Confucij/Gravicapa/README.md

Gravicapa
=========
Универсальное устройства для слежения за аудиториями, сбора различной информации, её обработки и отображения.
