Confucij/Gravicapa/datasheet/lqfp64_pins.png

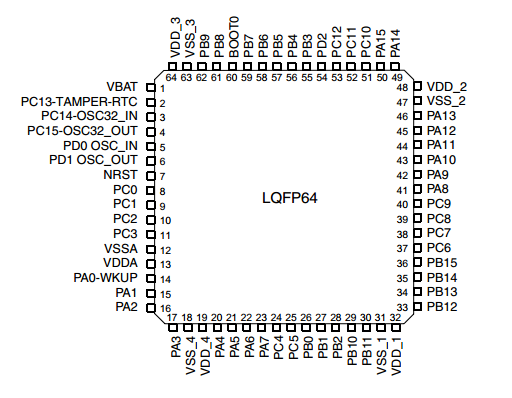
datasheet/lqfp64_pins.png
