Confucij/Gravicapa/documentation/Business Workflows.png

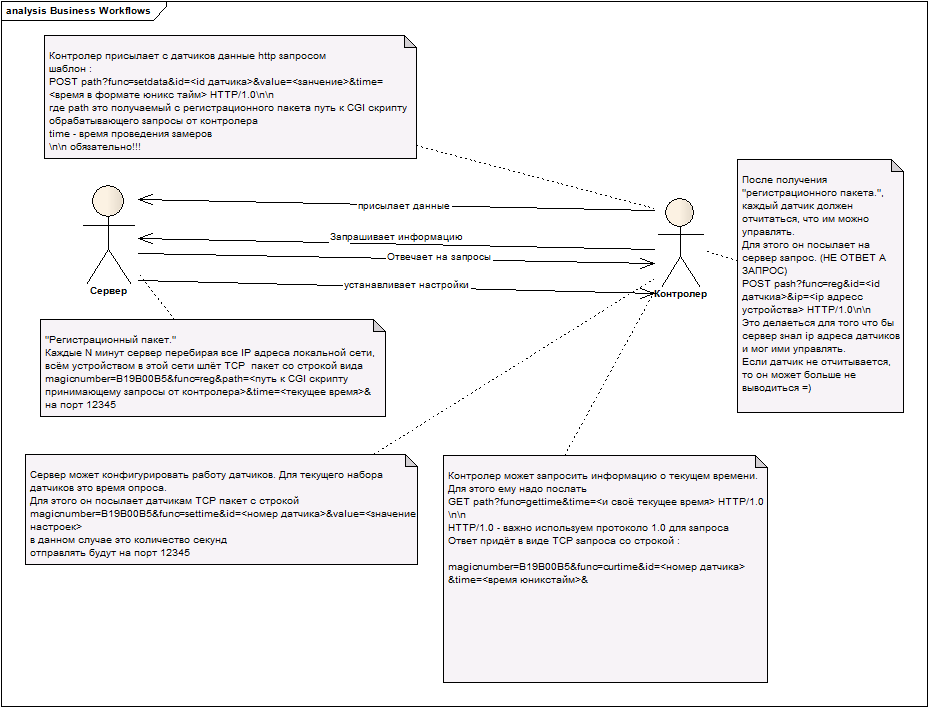
documentation/Business Workflows.png
