Confucij/Gravicapa/Component_select.md

Необходимое оборудывание
========================
    1. Связь с сервером.
        Ethernet.
             +простой контроллер( например);
             +наличие готового стека(uIP)
             +удобный интерфейс
             -необходимость наличия проводов с подключением к сети
            а)enc28j60
                Простая микросхема контроллер ethernet. 
                +Наличие готового кода.
                +Простота подключения
                -отсутствие TCP/IP стека
                -приличное количество багов
            б)W5100
                +аппаратная реализация протоколов TCP,  UDR  ICMR  IPv4 ARR  IGMR РРРоЕ, Ethernet;
                +встроенный 10BaseT/100BaseTX преобразователь физического уровня Ethernet;
                +автоматическое      определение режимов работы полный дуплекс, полудуплекс, 10 или 100 Мбит/с;
                +три способа подключения к микроконтроллеру. Direct, Indirect, SPI;
                +поддержка ADSL соединений по протоколу РРРоЕ;
                +возможность  работы   одновременно с четырьмя соединениями, каждое из которых настраивается для работы в режиме клиента или сервера;
                +16 Кбайт внутренней памяти, отведенной под буферы приема и передачи. 
                -Высше цена.
            в)W7200
                STM32F103CB+W5200                
                Максимальная частота работы 72 МГц (1,25 DMIPS/МГц).
                Область памяти данных (RAM) 20 Кб.
                Flash-память программ 128 Кб.
                7 таймеров:
                три 16-битных таймера и один вход для квадратурного кодера;
                два сторожевых таймера;
                24-битный вычитающий счётчик.
                Полнодуплексный UART.
                Блок аппаратного вычисления кода CRC.
                Внешние интерфейсы: GPIO, SPI, USART, I2C, CAN и USB.
                Режимы пониженного потребления энергии.
                Все возможности W5100 интегрированны внутрь
                +Повышение надежности за счет уменьшения числа компонентов
                +Отсутствие необходимости в еще одном контроллере для управления
                -Невозможность заменить процессор на плате на другой(Возможности заменить слабый STM на пожирнее и наоборот пропадает)
    2. Датчики
        а)Температура
            DS18B20
                +однопроводной цифровой интерфейс
                +возможность держать множество датчиков(не только температурных) на одной шине
        б)Потребляемая мощность
            ADE7753(ADE77**)
                Ошибка измерения активной составляющей мощности в диапазоне изменения тока 1000:1 менее 0.1 %
                Измерение активной, реактивной и допустимой мощности и СКЗ напряжения и тока
                Высокочастотный импульсный выход
                Измерение напряжения SAG, детектирование пересечения нуля, периода и пиковых значений напряжения и тока
                Режим накопления только положительной мощности
                Интерфейс с трансформаторными и дифференцирующими токовыми датчиками
                Встроенный температурный датчик и 2.4 В ИОН
                Низкое потребление: 25 мВт
            CS5460A
               Energy data linearity: ±0.1% of reading over 1000:1 dynamic range
               On-chip functions: energy, I * V, IRMS and VRMS, energy-to-pulse conversion
               Smart "Auto-Boot" mode from serial EEPROM
               AC or DC system calibration
               Mechanical counter/stepper motor driver
               Meets accuracy spec for IEC, ANSI, JIS
               Power consumption <12 mW
               On-chip 2.5 V reference (25 ppm/°C typ.)
               Interface optimized for shunt sensor
               Phase compensation
               Ground-referenced signals with single supply
               Simple 3-wire digital serial interface
               Watchdog timer
               Power-supply monitor
               Power supply configurations
                   VA+ = 5 V; VA- = 0 V; VD+ = 3 V to 5 V
                   VA+ = 2.5 V; VA- = -2.5 V; VD+ = 3 V
               Package: 24-pin SSOP; lead-free assembly
            MCP3905 
                +низкая цена
                +более доступна
                -не понятно как забрать показания
                -она вообще для этого нужна?
                The MCP3905 is an energy measurement IC supporting the IEC 62053 international
                energy metering specification. The output of the device includes a frequency 
                proportional to the average active (real) power at the inputs as well as a higher
                frequency output proportional to the instantaneous power for meter calibration. 
            STPM01
                труъ
               
        в)Освещения
            MAX44000
                Микросхема состоящая из датчика освещения и двух инфракрасных датчиков. Имеет встроенный драйвер для инфракрасного светодиода.
                Может быть использованна в качестве датчика присутствия. Интерфейс связи - I2C. 
            Фототранзистор/фотодиод
                Простой и дешевый способ реализации датчика освещения. Возможность определения только(?) наличия/отсутствия света. Необходимо подключать к АЦП.
        г)Открытие дверей/окон
            Геркон и постоянный магнит
    3. Карта памяти
        SD карта для ведения логов в отсутствии связи с сервером. Объем - от 1Гб.
    4. Видео/фотокамера
        Видеокамера позволяет вести наблюдение за помещением и передавать полученное изображение на сервер. В качестве камеры возможно использовать камеру от мобильного телефона
        или веб-камеру. 
        +Киллерфича.
        -Необходимы контроллеры с хорошей вычислительной мощностью
        -В случае с камерами от телефонов затруднено серийное производство
    5. Контроллер
        а)AVR
            +Простые в освоении и написании кода
            +Простые в распайке корпуса            
            -Малая тактовая частота(если необходим модуль с камерой частоты не хватит)
            -Сложно изменить применымый процессор - заменить менее производительный на более производительный так как зачастую нету полной совместимости выводов между корпусами
            -Производительные чипы с большими объемами памяти весьма дорогие.
        б)cortex-M3 от NXP
            +32х разрядное ARM ядро 
            +Высокие тактовые частоты
            +Большие объемы Flash и RAM
            -От линейки к линейке сильно меняется перевирия и распиновка чипов
            -Программировать сложнее чем AVR
        в)cortex-m3 от ST
            +32х разрядное ARM ядро 
            +Высокие тактовые частоты
            +Большие объемы Flash и RAM
            +Распиновка и внутренне устройство(адреса и названия регистров и т.п.) для различных по производительности контроллеров одинаковая, что позволяет, в зависимости от необходимой
            комплектации применять более или менее производительные чипы не внося изменений в программный код и конструкцию платы.
    6. Резервное питание, например http://forum.cxem.net/uploads/monthly_03_2011/post-55524-0-84197800-1300698730_thumb.jpg

Компоненты на главной плате
===========================
* Стабилизатор питания NCP1529
* Разъем Ethernet HR911105A
* Разъем microSD карты
* Ethernet контроллер enc28j60
* Посадочная площадка LQFP 64 под контроллер stm32(STM32F100RB для начала)
* Разъем батарейки cr2025(или другой плоской)
* Разъемы(штырьки) свободных i/o портов
* Разъемы(штырьки) шин i2C, 1-wire
* Температурный датчик
* Разъем питания
