Confucij/Gravicapa/scheme_and_board/component_order.ods

Название | Корпус | Цена | К-ство, шт | Ссылка | Комментарии | Сумма | Реально нужно, шт
kosmodrom.com.ua
STM32F100RBT6B | LQFP64 | 23.50 грн | 1 | http://www.kosmodrom.com.ua/el.php?name=STM32F100RBT6B | МС | 23.50 грн
enc28j60 | SSOP28 | 25.00 грн | 1 | http://www.kosmodrom.com.ua/prodlist.php?page=0&name=enc28j60 | МС | 25.00 грн
HR911105A | - | 16.50 грн | 1 | http://www.kosmodrom.com.ua/el.php?name=HR911105A | Разъем | 16.50 грн
CD54NP-101KC | SMD - | 2.50 грн | 1 | http://www.kosmodrom.com.ua/el.php?name=CD54NP-101KC | Дроссель, 100 мкГн | 2.50 грн
KX-3HT 25.0 MHz | HC49/U3H | 3.25 грн | 1 | http://www.kosmodrom.com.ua/prodlist.php?page=0&name=KX-3HT+25.0+MHz | Резонатор | 3.25 грн
SN2032 | CR2032P | 1.00 грн | 1 | http://www.kosmodrom.com.ua/prodlist.php?page=0&name=SN2032 | Батарейный отсек для CR2025 | 1.00 грн
MCC-SDMICRO/1 | - | 7.00 грн | 1 | http://www.kosmodrom.com.ua/el.php?name=mcc-sdmicro_1 | Держатель карты памяти | 7.00 грн
SI2301BDS-T1-E3 | SOT-23 | 1.50 грн | 5 | http://www.kosmodrom.com.ua/prodlist.php?page=0&name=SI230 | Транзистор MOSFET | 7.50 грн
BAV199.215 | SOT23 | 0.50 грн | 2 | http://www.kosmodrom.com.ua/prodlist.php?page=0&name=BAV199 | Диод быстрый | 1.00 грн
1N5817 | DO-41 | 0.50 грн | 1 | http://www.kosmodrom.com.ua/prodlist.php?page=0&name=1N5817 | Диод Шоттки | 0.50 грн
IRLML6402TRPBF | SOT-23 | 1.25 грн | 1 | http://www.kosmodrom.com.ua/prodlist.php?page=0&name=IRLML6402 | Транзистор полевой | 1.25 грн
BLM21PG221SN1D | SMD 0805 | 0.75 грн | 4 | http://www.kosmodrom.com.ua/el.php?name=BLM21PG221SN1D | Индуктивности | 3.00 грн
STM32F103C8T6 |  | 30.50 грн | 1 | http://www.kosmodrom.com.ua/el.php?name=STM32F103C8T6 |  | 30.50 грн
STM8S003F3P6 |  | 4.00 грн | 5 | http://www.kosmodrom.com.ua/el.php?name=STM8S003F3P6 |  | 20.00 грн
STM8SVLDISCOVERY |  | 126.75 грн | 1 | http://www.kosmodrom.com.ua/el.php?name=STM8SVLDISCOVERY |  | 126.75 грн | 1
STPM10BTR |  | 16.75 грн | 1 | http://www.kosmodrom.com.ua/el.php?name=STPM10BTR |  | 16.75 грн
STF202-22T1G |  | 2.50 грн | 2 |  |  | 5.00 грн
radiomarket.lg.ua |  |  |  |  |  |  | 2
T491B106K016AS | CASE B | 1.25 грн | 1 | http://radiomarket.lg.ua/product_info.php/cPath/334_340_356/products_id/20834 | Конденсатор, 10мкФ 10В | 1.25 грн | 15
Резистор | SMD 0805 | 0.05 грн | 10 | http://radiomarket.lg.ua/product_info.php/cPath/334_665_683/products_id/4035 | Резистор, 2.2к | 0.50 грн | 4
Резистор | SMD 0805 | 0.05 грн | 10 | http://radiomarket.lg.ua/product_info.php/cPath/334_665_683/products_id/4037 | Резистор, 2.7к | 0.50 грн | 2
Резистор | SMD 0805 | 0.05 грн | 10 | http://radiomarket.lg.ua/product_info.php/cPath/334_665_683/products_id/4034 | Резистор, 2.0к | 0.50 грн | 5
Резистор | SMD 0805 | 0.05 грн | 10 | http://radiomarket.lg.ua/product_info.php/cPath/334_665_683/products_id/4007 | Резистор, 150 Ом | 0.50 грн | 8
Резистор | SMD 0805 | 0.05 грн | 20 | http://radiomarket.lg.ua/product_info.php/cPath/334_665_683/products_id/4051 | Резистор, 10к | 1.00 грн | 2
Резистор | SMD 0805 | 0.05 грн | 10 | http://radiomarket.lg.ua/product_info.php/cPath/334_665_683/products_id/3996 | Резистор, 51 Ом(нужно 50 1%) | 0.50 грн | 2
Резистор | SMD 0805 | 0.05 грн | 10 | http://radiomarket.lg.ua/product_info.php/products_id/4019 | Резистор, 470 | 0.50 грн | 2
Резистор | SMD 0805 | 0.05 грн | 10 | http://radiomarket.lg.ua/product_info.php/cPath/334_665_683/products_id/4043 | Резистор, 4.7к | 0.50 грн
Конденсатор | SMD 0805 | 0.10 грн | 10 | http://radiomarket.lg.ua/product_info.php/cPath/334_340_357/products_id/6699 | Конденсатор 0.1 мкФ | 1.00 грн
Конденсатор | SMD 0805 | 0.10 грн | 10 | http://radiomarket.lg.ua/product_info.php/cPath/334_340_357/products_id/6691 | Конденсатор 0.01мкФ | 1.00 грн
Конденсатор | SMD 0805 | 0.05 грн | 10 | http://radiomarket.lg.ua/product_info.php/cPath/334_340_357/products_id/6640 | Конденсатор 20пФ(нужно 18) | 0.50 грн
Конденсатор | SMD 0805 | 0.05 грн | 10 | http://radiomarket.lg.ua/product_info.php/products_id/6641 | Конденсатор 22пФ | 0.50 грн
Конденсатор Электр-й |  | 1.85 грн | 1 | http://radiomarket.lg.ua/product_info.php/cPath/334_340_360/products_id/18622 | Конденсатор Электр-й 470 мкФ | 1.85 грн
DS18B20 | TO-92 | 10.60 грн | 2 | http://radiomarket.lg.ua/product_info.php/products_id/8382 | Термодатчик | 21.20 грн
301-02P(5.0ММ) | 2в. инт 5 | 0.70 грн | 6 | http://radiomarket.lg.ua/product_info.php/cPath/194_195/products_id/2035 | КЛЕММНИК 3ВЫВОДА | 4.20 грн
306-03P(5.0ММ) | 3в. инт 5 | 1.35 грн | 3 | http://radiomarket.lg.ua/product_info.php/cPath/194_195/products_id/2075 | КЛЕММНИК 2ВЫВОДА | 4.05 грн
MLG4416(RD=5-10KOM) | 2в. инт 2.5 | 1.10 грн | 1 | http://radiomarket.lg.ua/product_info.php/cPath/334_665_790/products_id/7296 | ФОТОРЕЗИСТОР | 1.10 грн
LM1117IDT-ADJ | DPAK | 6.30 грн | 1 | http://radiomarket.lg.ua/product_info.php/products_id/12354 | Стабилизатор 3.3 | 6.30 грн
Жало B2-2/d=4,8mm, плоско |  | 10.95 грн | 1 | http://radiomarket.lg.ua/product_info.php/cPath/54_83_88/products_id/7167 |  | 10.95 грн
Курс $: | 8.1031 |  |  |  |  | 338.45 грн
Ещё нет в списке:
Резонатор 8 МГц
Двухсторонний текстолит
Штырьки
