Confucij/Gravicapa/scheme_and_board/mainboard.pdf

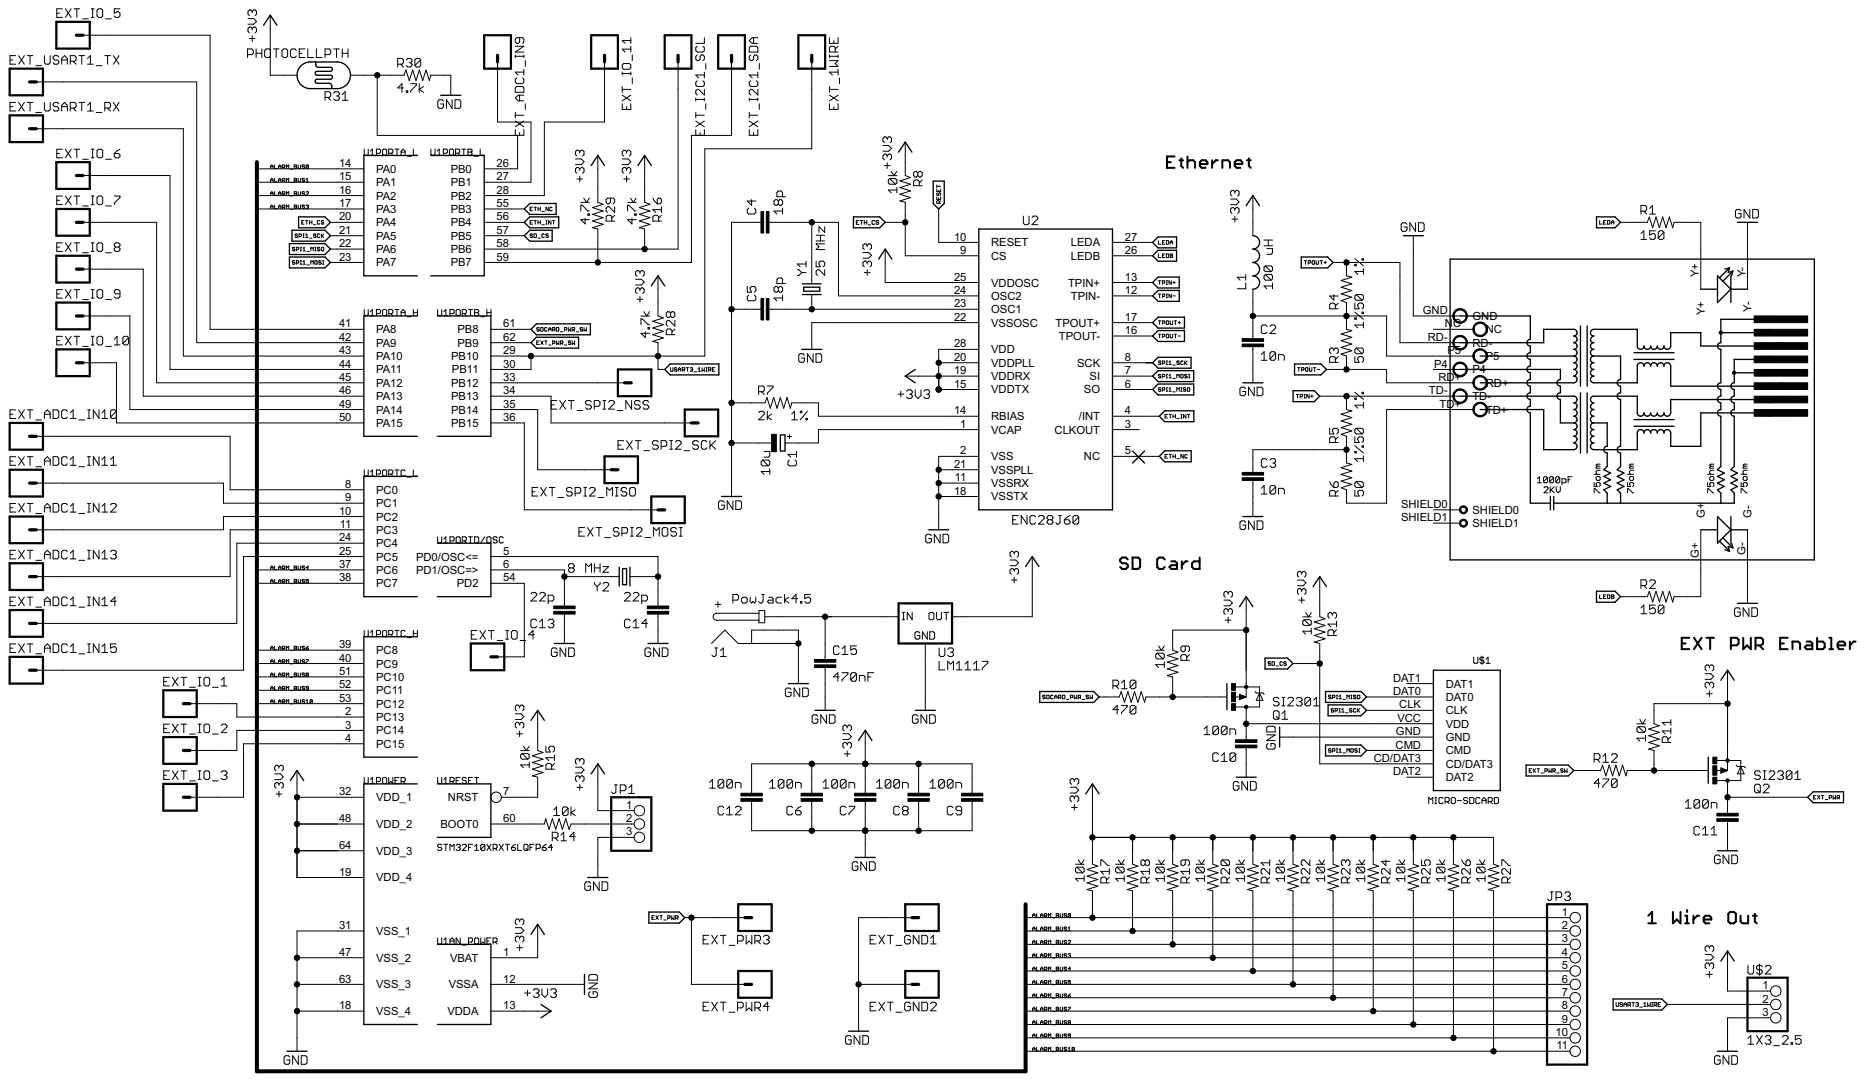
[picture p3: page 1]
