Confucij/Gravicapa/scheme_and_board/Gravicapa/mainboard.brd

## EAGLE design scheme_and_board/Gravicapa/mainboard.brd (2012-12-06)

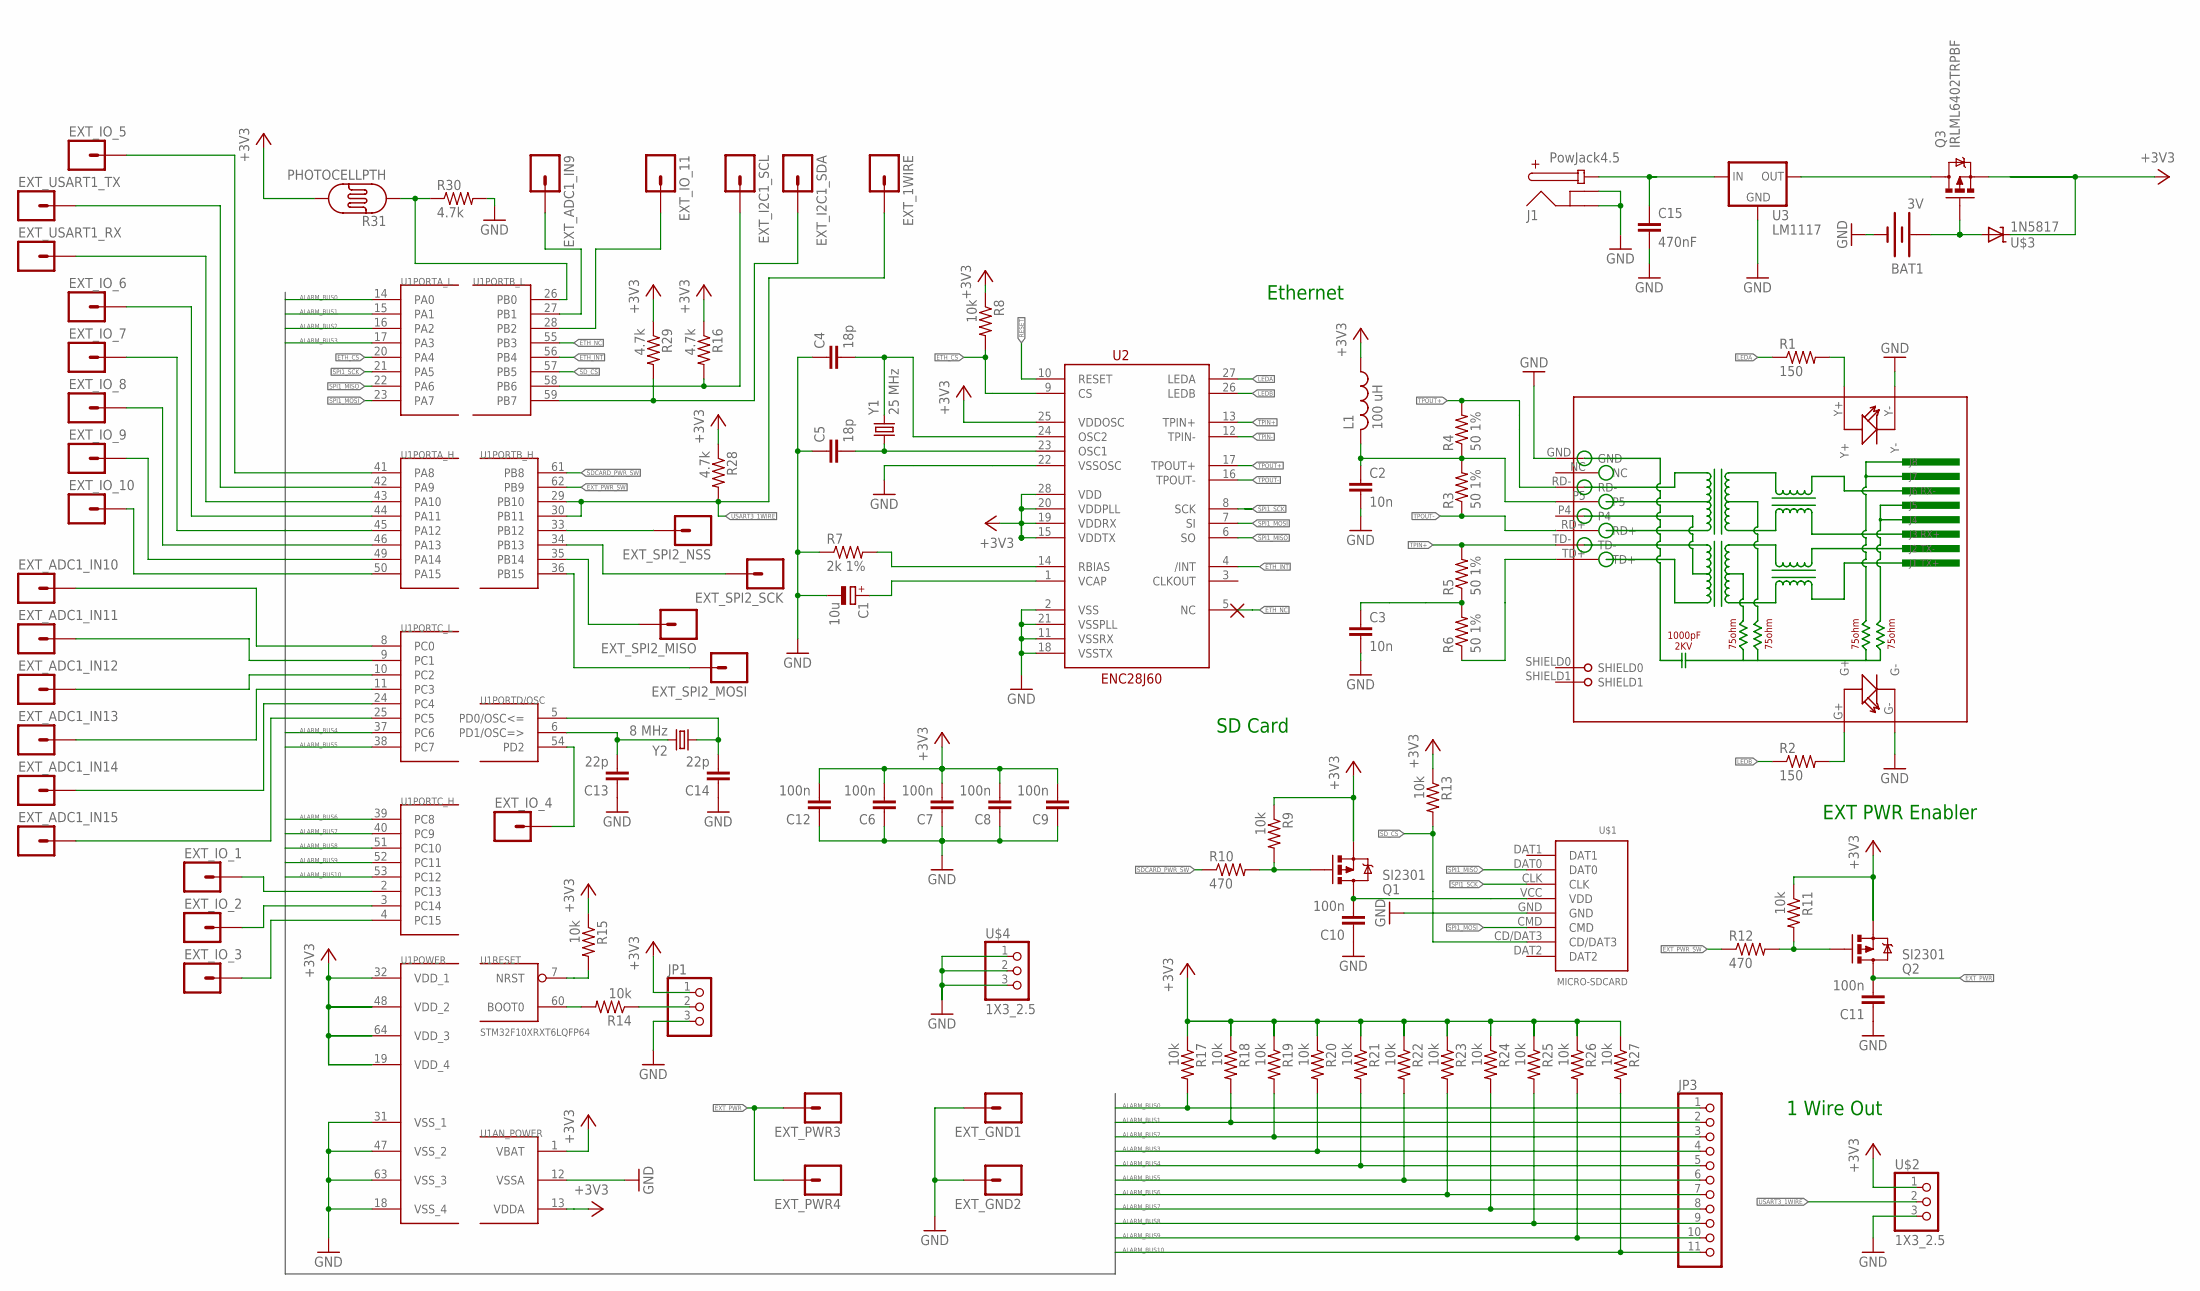
[picture p4: schematic mainboard.sch]

Parts:
BAT1: 3V; BATTCOM_20MM_PTH
C1: 10u; SMC_B
C2, C3: 10n; 0805
C4, C5: 18p; 0805
C6, C7, C8, C9, C10, C11, C12: 100n; 0805
C13, C14: 22p; 0805
C15: 470nF; C1206
EXT_1WIRE: M01PTH; 1X01
EXT_ADC1_IN9, EXT_ADC1_IN10, EXT_ADC1_IN11, EXT_ADC1_IN12, EXT_ADC1_IN13, EXT_ADC1_IN14, EXT_ADC1_IN15: M01PTH; 1X01
EXT_GND1, EXT_GND2: M01PTH; 1X01
EXT_I2C1_SCL, EXT_I2C1_SDA: M01PTH; 1X01
EXT_IO_1, EXT_IO_2, EXT_IO_3, EXT_IO_4, EXT_IO_5, EXT_IO_6, EXT_IO_7, EXT_IO_8, EXT_IO_9, EXT_IO_10, EXT_IO_11: M01PTH; 1X01
EXT_PWR3, EXT_PWR4: M01PTH; 1X01
EXT_SPI2_MISO, EXT_SPI2_MOSI, EXT_SPI2_NSS, EXT_SPI2_SCK: M01PTH; 1X01
EXT_USART1_RX, EXT_USART1_TX: M01PTH; 1X01
J1: PowJack4.5; POWER_JACK_4.5
JP1: PINHD-1X3; 1X03
JP3: PINHD-1X11; 1X11
L1: 100 uH; POWER-CHOKE_WE-TPC
Q1, Q2: SI2301; SOT23-3
Q3: IRLML6402TRPBF; SOT23-3
R1, R2: 150; 0805
R3, R4, R5, R6: 50 1%; 0805
R7: 2k 1%; 0805
R8, R9, R11, R13, R14, R15, R17, R18, R19, R20, R21, R22, R23, R24, R25, R26, R27: 10k; 0805
R10, R12: 470; 0805
R16, R28, R29, R30: 4.7k; 0805
R31: PHOTOCELLPTH; PHOTOCELL
RJ1: HR911105A
U1: STM32F10XRXT6LQFP64; LQFP64_MILL
U2: ENC28J60; SSOP28DB
U3: LM1117; DPAK
U$1: MICRO-SDCARD
U$2, U$4: 1X3_2.5
U$3: 1N5817; DIODE-ZENER
Y1: 25 MHz; HC49U-V
Y2: 8 MHz; HC49U-V

Connections:
+3V3: C6.2, C7.2, C8.2, C9.2, C12.2, JP1.1, L1.1, Q1.2 (S), Q2.2 (S), Q3.2 (S), R8.1, R9.1, R11.1, R13.1, R15.1, R16.1, R17.1, R18.1, R19.1, R20.1, R21.1, R22.1, R23.1, R24.1, R25.1, R26.1, R27.1, R28.1, R29.1, R31.2, U1.1 (VBAT), U1.13 (VDDA), U1.19 (VDD_4), U1.32 (VDD_1), U1.48 (VDD_2), U1.64 (VDD_3), U2.15 (VDDTX), U2.19 (VDDRX), U2.20 (VDDPLL), U2.25 (VDDOSC), U2.28 (VDD), U$2.1, U$3.P$1 (C)
ALARM_BUS0: JP3.1, R17.2, U1.14 (PA0)
ALARM_BUS1: JP3.2, R18.2, U1.15 (PA1)
ALARM_BUS2: JP3.3, R19.2, U1.16 (PA2)
ALARM_BUS3: JP3.4, R20.2, U1.17 (PA3)
ALARM_BUS4: JP3.5, R21.2, U1.37 (PC6)
ALARM_BUS5: JP3.6, R22.2, U1.38 (PC7)
ALARM_BUS6: JP3.7, R23.2, U1.39 (PC8)
ALARM_BUS7: JP3.8, R24.2, U1.40 (PC9)
ALARM_BUS8: JP3.9, R25.2, U1.51 (PC10)
ALARM_BUS9: JP3.10, R26.2, U1.52 (PC11)
ALARM_BUS10: JP3.11, R27.2, U1.53 (PC12)
ETH_CS: R8.2, U1.20 (PA4), U2.9 (CS)
ETH_INT: U1.56 (PB4), U2.4 (/INT)
ETH_NC: U1.55 (PB3), U2.5 (NC)
EXT_PWR: C11.2, EXT_PWR3.1, EXT_PWR4.1, Q2.3 (D)
EXT_PWR_SW: R12.1, U1.62 (PB9)
GND: BAT1.2 (-), C1.-, C2.2, C3.2, C4.1, C5.1, C6.1, C7.1, C8.1, C9.1, C10.1, C11.1, C12.1, C13.1, C14.1, C15.2, EXT_GND1.1, EXT_GND2.1, J1.GND@1 (GND), J1.GND@2 (GNDBREAK), JP1.3, R7.1, R30.2, RJ1.G-, RJ1.GND, RJ1.Y-, U1.12 (VSSA), U1.18 (VSS_4), U1.31 (VSS_1), U1.47 (VSS_2), U1.63 (VSS_3), U2.2 (VSS), U2.11 (VSSRX), U2.18 (VSSTX), U2.21 (VSSPLL), U2.22 (VSSOSC), U3.1 (GND), U$1.GND, U$2.3, U$4.1, U$4.2, U$4.3
I2C1_SCL: EXT_I2C1_SCL.1, R16.2, U1.58 (PB6)
I2C1_SDA: EXT_I2C1_SDA.1, R29.2, U1.59 (PB7)
LEDA: R1.1, U2.27 (LEDA)
LEDB: R2.1, U2.26 (LEDB)
unnamed: C2.1, L1.2, R3.2, R4.1, RJ1.P5
unnamed: R2.2, RJ1.G+
unnamed: R1.2, RJ1.Y+
unnamed: R7.2, U2.14 (RBIAS)
unnamed: C5.2, U2.23 (OSC1), Y1.1
unnamed: C4.2, U2.24 (OSC2), Y1.2
unnamed: C1.+, U2.1 (VCAP)
unnamed: Q2.1 (G), R11.2, R12.2
unnamed: C3.1, R5.1, R6.2
unnamed: Q1.1 (G), R9.2, R10.2
unnamed: C10.2, Q1.3 (D), U$1.VCC (VDD)
unnamed: EXT_IO_1.1, U1.2 (PC13)
unnamed: R14.2, U1.60 (BOOT0)
unnamed: JP1.2, R14.1
unnamed: R15.2, U1.7 (NRST)
unnamed: C14.2, U1.5 (PD0/OSC<=), Y2.1
unnamed: C13.2, U1.6 (PD1/OSC=>), Y2.2
unnamed: C15.1, J1.PWR, U3.3 (IN)
unnamed: EXT_IO_2.1, U1.3 (PC14)
unnamed: EXT_IO_3.1, U1.4 (PC15)
unnamed: EXT_IO_4.1, U1.54 (PD2)
unnamed: EXT_IO_5.1, U1.41 (PA8)
unnamed: EXT_USART1_TX.1, U1.42 (PA9)
unnamed: EXT_USART1_RX.1, U1.43 (PA10)
unnamed: EXT_IO_6.1, U1.44 (PA11)
unnamed: EXT_IO_7.1, U1.45 (PA12)
unnamed: EXT_IO_8.1, U1.46 (PA13)
unnamed: EXT_IO_9.1, U1.49 (PA14)
unnamed: EXT_IO_10.1, U1.50 (PA15)
unnamed: R30.1, R31.1, U1.26 (PB0)
unnamed: EXT_ADC1_IN9.1, U1.27 (PB1)
unnamed: EXT_ADC1_IN15.1, U1.25 (PC5)
unnamed: EXT_ADC1_IN14.1, U1.24 (PC4)
unnamed: EXT_ADC1_IN13.1, U1.11 (PC3)
unnamed: EXT_ADC1_IN12.1, U1.10 (PC2)
unnamed: EXT_ADC1_IN11.1, U1.9 (PC1)
unnamed: EXT_ADC1_IN10.1, U1.8 (PC0)
unnamed: BAT1.1 (+), Q3.1 (G), U$3.P$2 (A)
unnamed: EXT_IO_11.1, U1.28 (PB2)
unnamed: Q3.3 (D), U3.4 (OUT)
RESET: U2.10 (RESET)
SDCARD_PWR_SW: R10.1, U1.61 (PB8)
SD_CS: R13.2, U1.57 (PB5), U$1.CD/DAT3
SPI1_MISO: U1.22 (PA6), U2.6 (SO), U$1.DAT0
SPI1_MOSI: U1.23 (PA7), U2.7 (SI), U$1.CMD
SPI1_SCK: U1.21 (PA5), U2.8 (SCK), U$1.CLK
SPI2_MISO: EXT_SPI2_MISO.1, U1.35 (PB14)
SPI2_MOSI: EXT_SPI2_MOSI.1, U1.36 (PB15)
SPI2_NSS: EXT_SPI2_NSS.1, U1.33 (PB12)
SPI2_SCK: EXT_SPI2_SCK.1, U1.34 (PB13)
TPIN+: R5.2, RJ1.TD-, U2.13 (TPIN+)
TPIN-: R6.1, RJ1.TD+, U2.12 (TPIN-)
TPOUT+: R4.2, RJ1.RD-, U2.17 (TPOUT+)
TPOUT-: R3.1, RJ1.RD+, U2.16 (TPOUT-)
USART3_1WIRE: EXT_1WIRE.1, R28.2, U1.29 (PB10), U1.30 (PB11), U$2.2

Notes on the sheet:
Ethernet
EXT PWR Enabler
SD Card
1 Wire Out

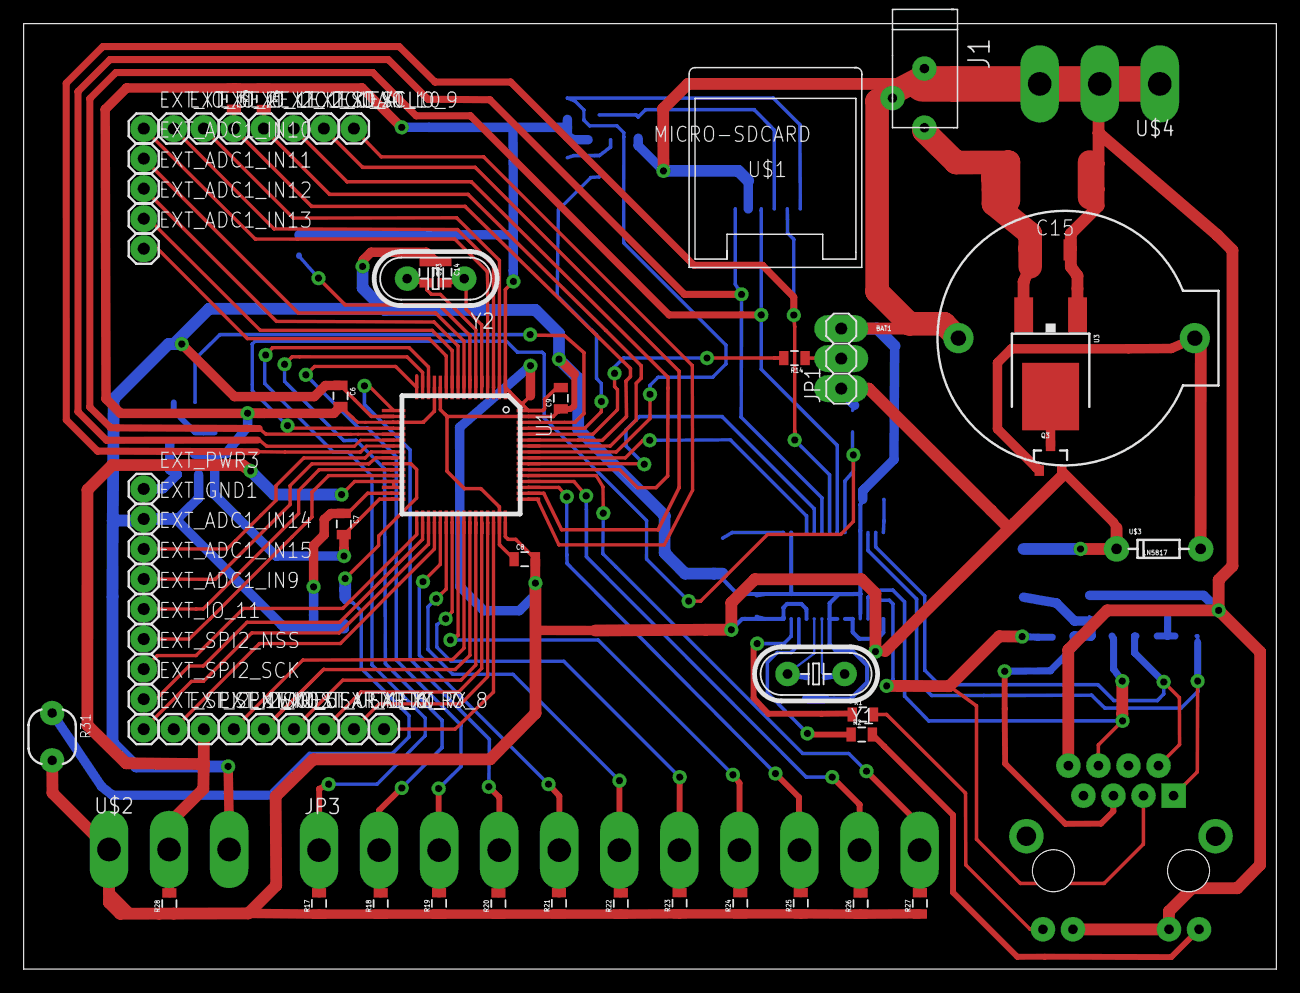
[picture p5: board mainboard.brd from above]

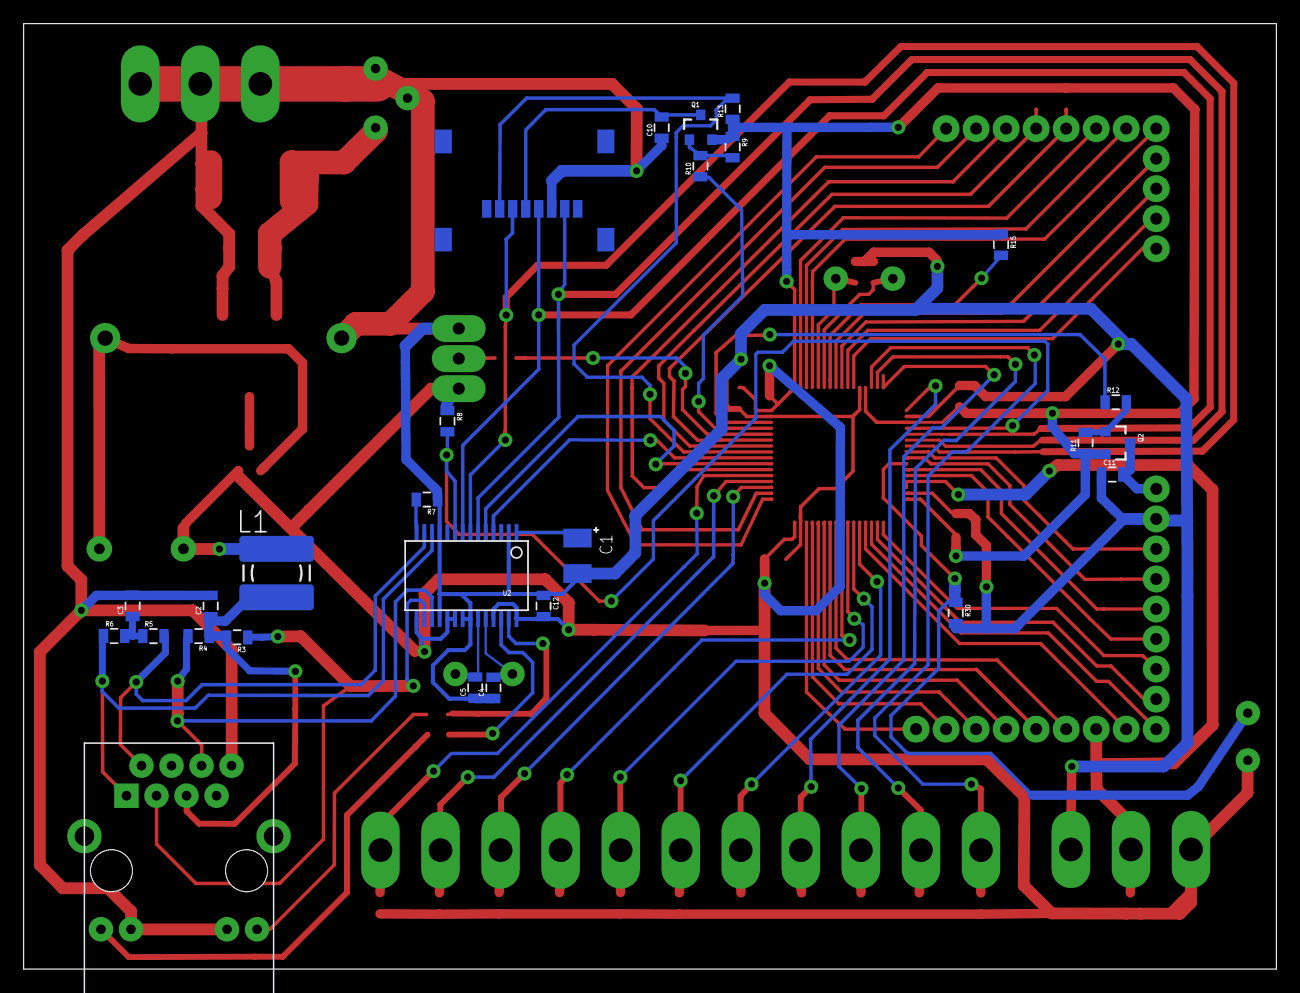
[picture p6: board mainboard.brd from below]

Board: 2 copper layers, 106.0 x 80.0 mm, 93 parts (26 on the bottom side), 76 nets.
