Confucij/Gravicapa/scheme_and_board/Gravicapa/1-wire_board.brd

## EAGLE design scheme_and_board/Gravicapa/1-wire_board.brd (2012-09-30)

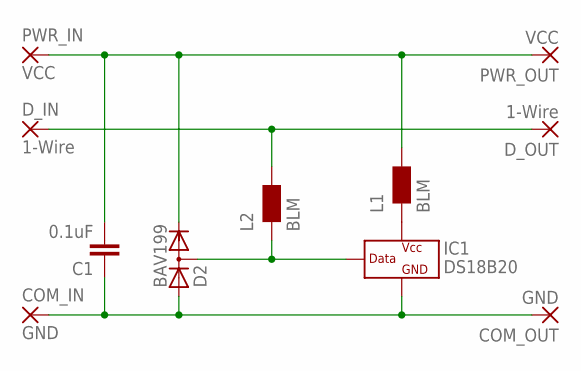
[picture p7: schematic 1-wire_board.sch]

Parts:
C1: 0.1uF; 0805
COM_IN: GND; SMD2,54-5,08
COM_OUT: GND; SMD2,54-5,08
D2: BAV199; SOT23
D_IN: 1-Wire; SMD2,54-5,08
D_OUT: 1-Wire; SMD2,54-5,08
IC1: DS18B20; TO92-
L1, L2: BLM; 0805
PWR_IN: VCC; SMD2,54-5,08
PWR_OUT: VCC; SMD2,54-5,08

Connections:
unnamed: D2.3 (AC), IC1.2 (DATA), L2.1
unnamed: D_IN.1, D_OUT.1, L2.2
unnamed: C1.1, COM_IN.1, COM_OUT.1, D2.1 (A), IC1.1 (GND)
unnamed: C1.2, D2.2 (C), L1.2, PWR_IN.1, PWR_OUT.1
unnamed: IC1.3 (VCC), L1.1

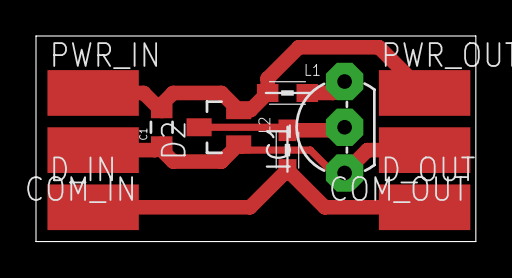
[picture p8: board 1-wire_board.brd from above]

Board: 2 copper layers, 24.4 x 11.4 mm, 11 parts (0 on the bottom side), 5 nets.
