Confucij/Gravicapa/(commit log)

2012-09-06 Выбор компонентов
2012-09-08 Изменение списка компонентов
2012-09-09 Добавил шаблон кода для контроллера. Включены CMSIS и StdPL, скрипт для линкера и файл стартовой инициализации. Для добавления файла из SPL в проект можно добавить его в мейкфайл или поместить в папк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
2012-09-09 Добавил код драйвера Fat. Еще не тестировал.
2012-09-11 Протестировал файловую систему. Иногда работает.
2012-09-12 Проверил работу ФС - работает вроде. Режим ДМА не проверял
2012-09-12 Включил DMA. Вроди работает.
2012-09-12 Забыл добавить кусок DMA
2012-09-12 Added EAGLE library with some components, and order list
    Lib contains:
    STM32F100RBT6B
    enc28j60
    HR911105A
    CD54NP-101KC
    [component_order.ods]
2012-09-13 Board&Scheme, Commit 13.09
    Added some components to lib, created EagleCad project file and scheme
    file. Scheme contain enc28j60 and components related to it.
    [component_order.ods, gravicapa.sch]
2012-09-15 Схема 15.09
    [component_order.ods, gravicapa.sch]
2012-09-15 Добавлен PDF файл схемы, и внесены небольшие поправки
    [component_order.ods]
2012-09-17 Обновил библиотеку
2012-09-20 corrected scheme
    [mainboard.sch]
2012-09-29 1-wire board and scheme add.
    [1-wire_board.brd, 1-wire_board.sch]
2012-09-29 Mainboard shceme modified: SPI1 NSS connected to eth_cs
    [mainboard.sch]
2012-10-14 scheme edited. All pins used, added photosensor, interrupt pins moved for simplefing PCB. Pins for external board now are separeted for easy moving on PCB
    [component_order.ods, mainboard.sch]
2012-10-21 battarey backup. Mainboard PCB. Not routed.
    [component_order.ods, mainboard.brd, mainboard.sch]
2012-10-23 comp order
    [component_order.ods]
2012-10-23 PCB in PDF format
2012-10-24 topor src added
    [mainboard.dsn]
2012-10-24 topor cleaned
    [mainboard.dsn]
2012-11-01 Order change
    [component_order.ods]
2012-11-28 eagle board
2012-12-02 ENC28J60 driver add.
2012-12-08 Создал две задачи: переодическую и с очередью. Включил инклюды стека
2012-12-08 Добавил к компиляции исходники стека.
2012-12-13 Onewire add and work(?) for 1 sensor
